NailAlex/KillSwitchDuino/Docs/pcb_basic_image.jpg

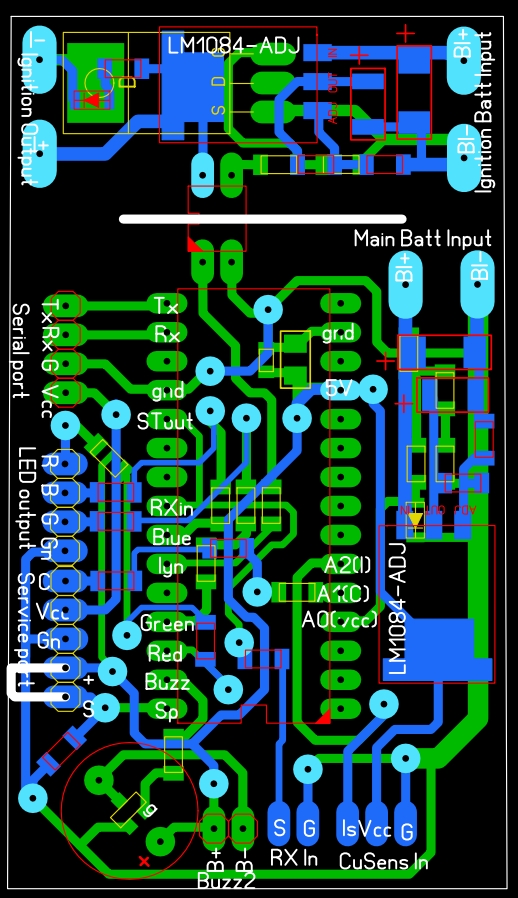
Docs/pcb_basic_image.jpg
