NailAlex/KillSwitchDuino/images/arduino_nano.jpg

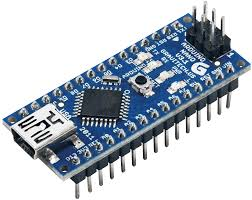
images/arduino_nano.jpg
