NailAlex/KillSwitchDuino/Shemes/KillSwitchDuino_Basic_WiringSheme.pdf

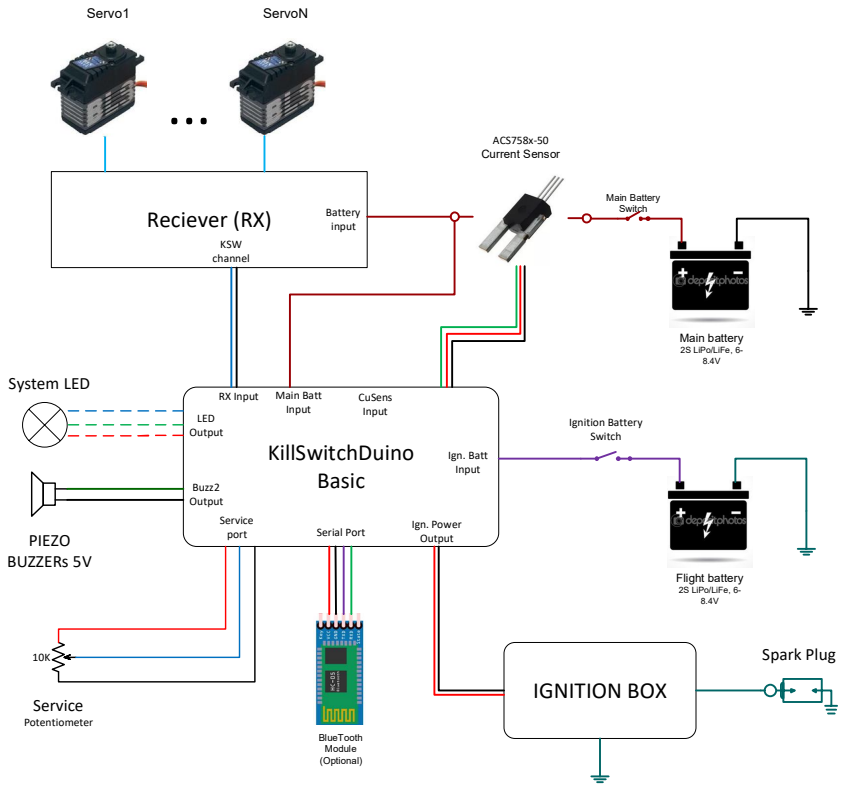
[picture p6: page 1]
Main battery; 2S LiPo/LiFe, 6- 8.4V; Main Battery Switch; KillSwitchDuino Basic; System LED; Main Batt Input; CuSens Input; Buzz2 Output; RX Input; Flight battery; IGNITION BOX; Ign. Batt Input; Reciever (RX); ServoN; Servo1; KSW channel; Ignition Battery Switch; Battery input; ACS758x-50 Current Sensor; Ign. Power Output; Spark Plug; LED Output; PIEZO BUZZERs 5V; Service; Potentiometer; port; Serial Port; BlueTooth Module (Optional)
