NailAlex/KillSwitchDuino/Shemes/KillSwitchDuino_Basic_ElectricSheme.pdf

6.0-8.4V

## RX JACK

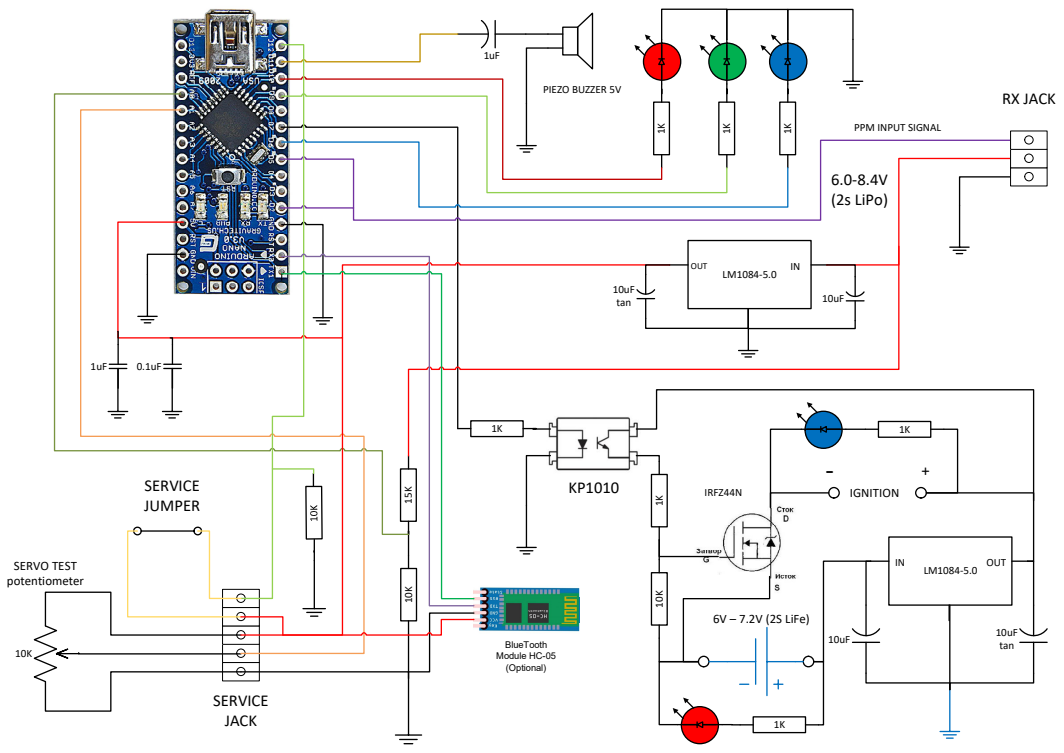
[picture p7: page 1]
6V – 7.2V (2S LiFe); OUT; IGNITION; (2s LiPo); 10uF tan; tan; IRFZ44N; SERVICE JUMPER; SERVO TEST potentiometer; SERVICE JACK; PIEZO BUZZER 5V; BlueTooth Module HC-05 (Optional)

PPM INPUT SIGNAL
