NailAlex/KillSwitchDuino/Shemes/KillSwitchDuino_HV_ElectricSheme.pdf

## HV SERVOS JACKS

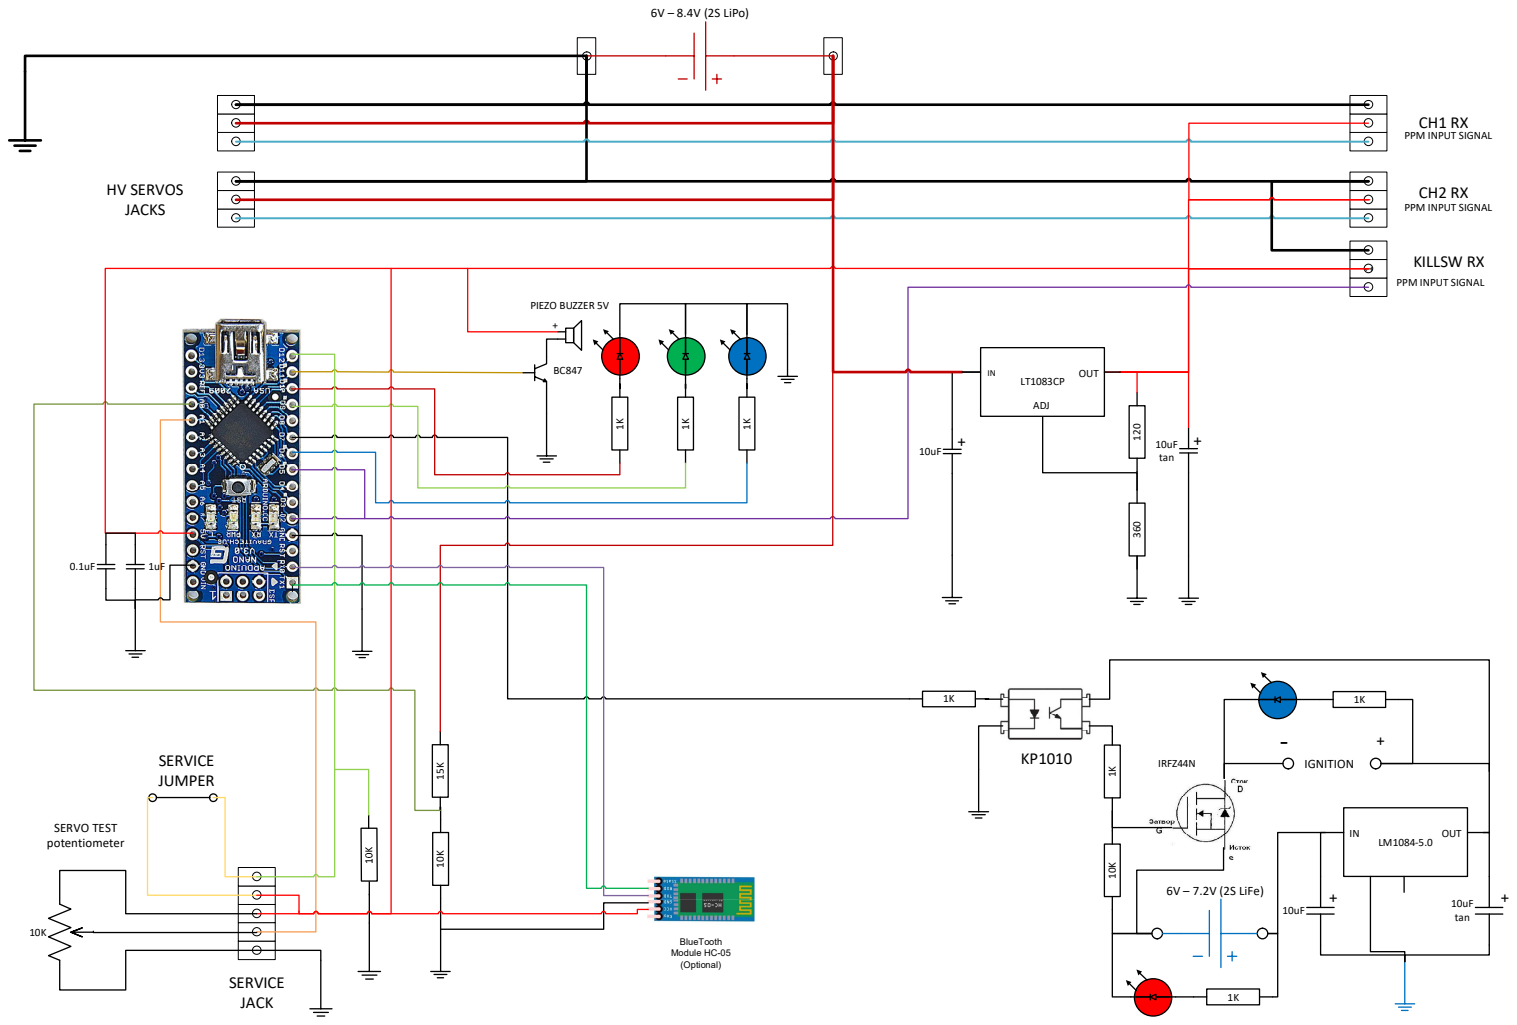
[picture p8: page 1]
6V – 7.2V (2S LiFe); OUT; IGNITION; IRFZ44N; 6V – 8.4V (2S LiPo); KILLSW RX; SERVICE JUMPER; SERVO TEST potentiometer; SERVICE JACK; tan; 10uF tan; ADJ; PIEZO BUZZER 5V; BlueTooth Module HC-05 (Optional)

PPM INPUT SIGNAL
