NailAlex/KillSwitchDuino/Docs/Menu_Struc.pdf

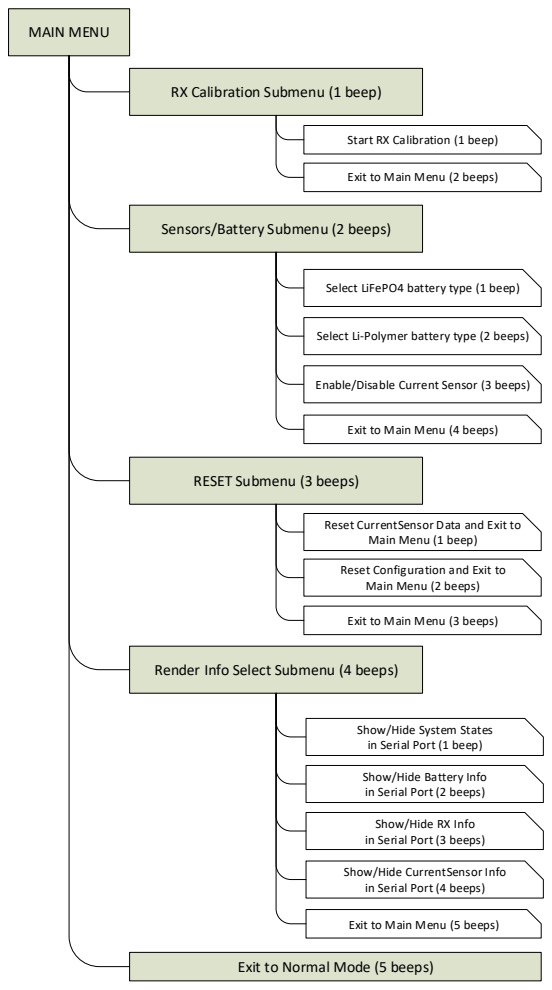
[picture p9: page 1]
MAIN MENU

RX Calibration Submenu (1 beep)

Start RX Calibration (1 beep)

Exit to Main Menu (2 beeps)

Sensors/Battery Submenu (2 beeps)

Select LiFePO4 battery type (1 beep)

Select Li-Polymer battery type (2 beeps)

Enable/Disable Current Sensor (3 beeps)

Exit to Main Menu (4 beeps)

RESET Submenu (3 beeps)

Reset CurrentSensor Data and Exit to

Main Menu (1 beep)

Reset Configuration and Exit to
Main Menu (2 beeps)

Exit to Main Menu (3 beeps)

Render Info Select Submenu (4 beeps)

Show/Hide System States
in Serial Port (1 beep)

Show/Hide Battery Info
in Serial Port (2 beeps)

Show/Hide RX Info
in Serial Port (3 beeps)

Show/Hide CurrentSensor Info
in Serial Port (4 beeps)

Exit to Main Menu (5 beeps)

Exit to Normal Mode (5 beeps)
