NailAlex/KillSwitchDuino/(list of files, drawings)

Other design files:
Baseboards(PCB)/KillSWduino_Basic_v2.lay6
Baseboards(PCB)/KillSWduinoHV2_v2.lay6
