NailAlex/KillSwitchDuino/(commit log)

2016-07-04 Added 2 version baseboard
    Added 2 version baseboard - basic and with HV-power disjunction sheme
    [KillSWduinoHV.lay, KillSWduino_Basic.lay]
2016-07-05 correct mark
    [KillSWduino_Basic.lay]
2016-07-11 Menu Code Added!
    - Full functional Menu added to code
    - add Timer Library to Libraries
    - add Menu structure readme to Docs
2016-10-24 Ver 2 PCB
    Ver 2 PCBs and readme
    [KillSWduinoHV.lay, KillSWduinoHV2_v2.lay6, KillSWduino_Basic.lay, KillSWduino_Basic_v2.lay6]
2016-10-24 Add Basic wiring connection sheme
    Add Basic wiring connection sheme
2016-10-24 Add Basic Wiring sheme
2016-11-30 Version 2.2
    Docs under Construction!
    [KillSWduino_Basic_v2.lay6]
2016-12-04 Correct RX signal detect
    Correct RX signal detection, NoRX switch processing, comments
    [KillSwitchduino.ino]
2017-01-28 ver 2.3 beta
    many changes
    add current sensor
    [KillSWduino_Basic_v2.lay6]
2017-03-04 graphic PCb added
    graphic PCb added
